TooTallNate/nixie-esp32/hardware/nixie-esp32.kicad_pcb

## KiCad design hardware/nixie-esp32.kicad_pcb (2026-09-01)

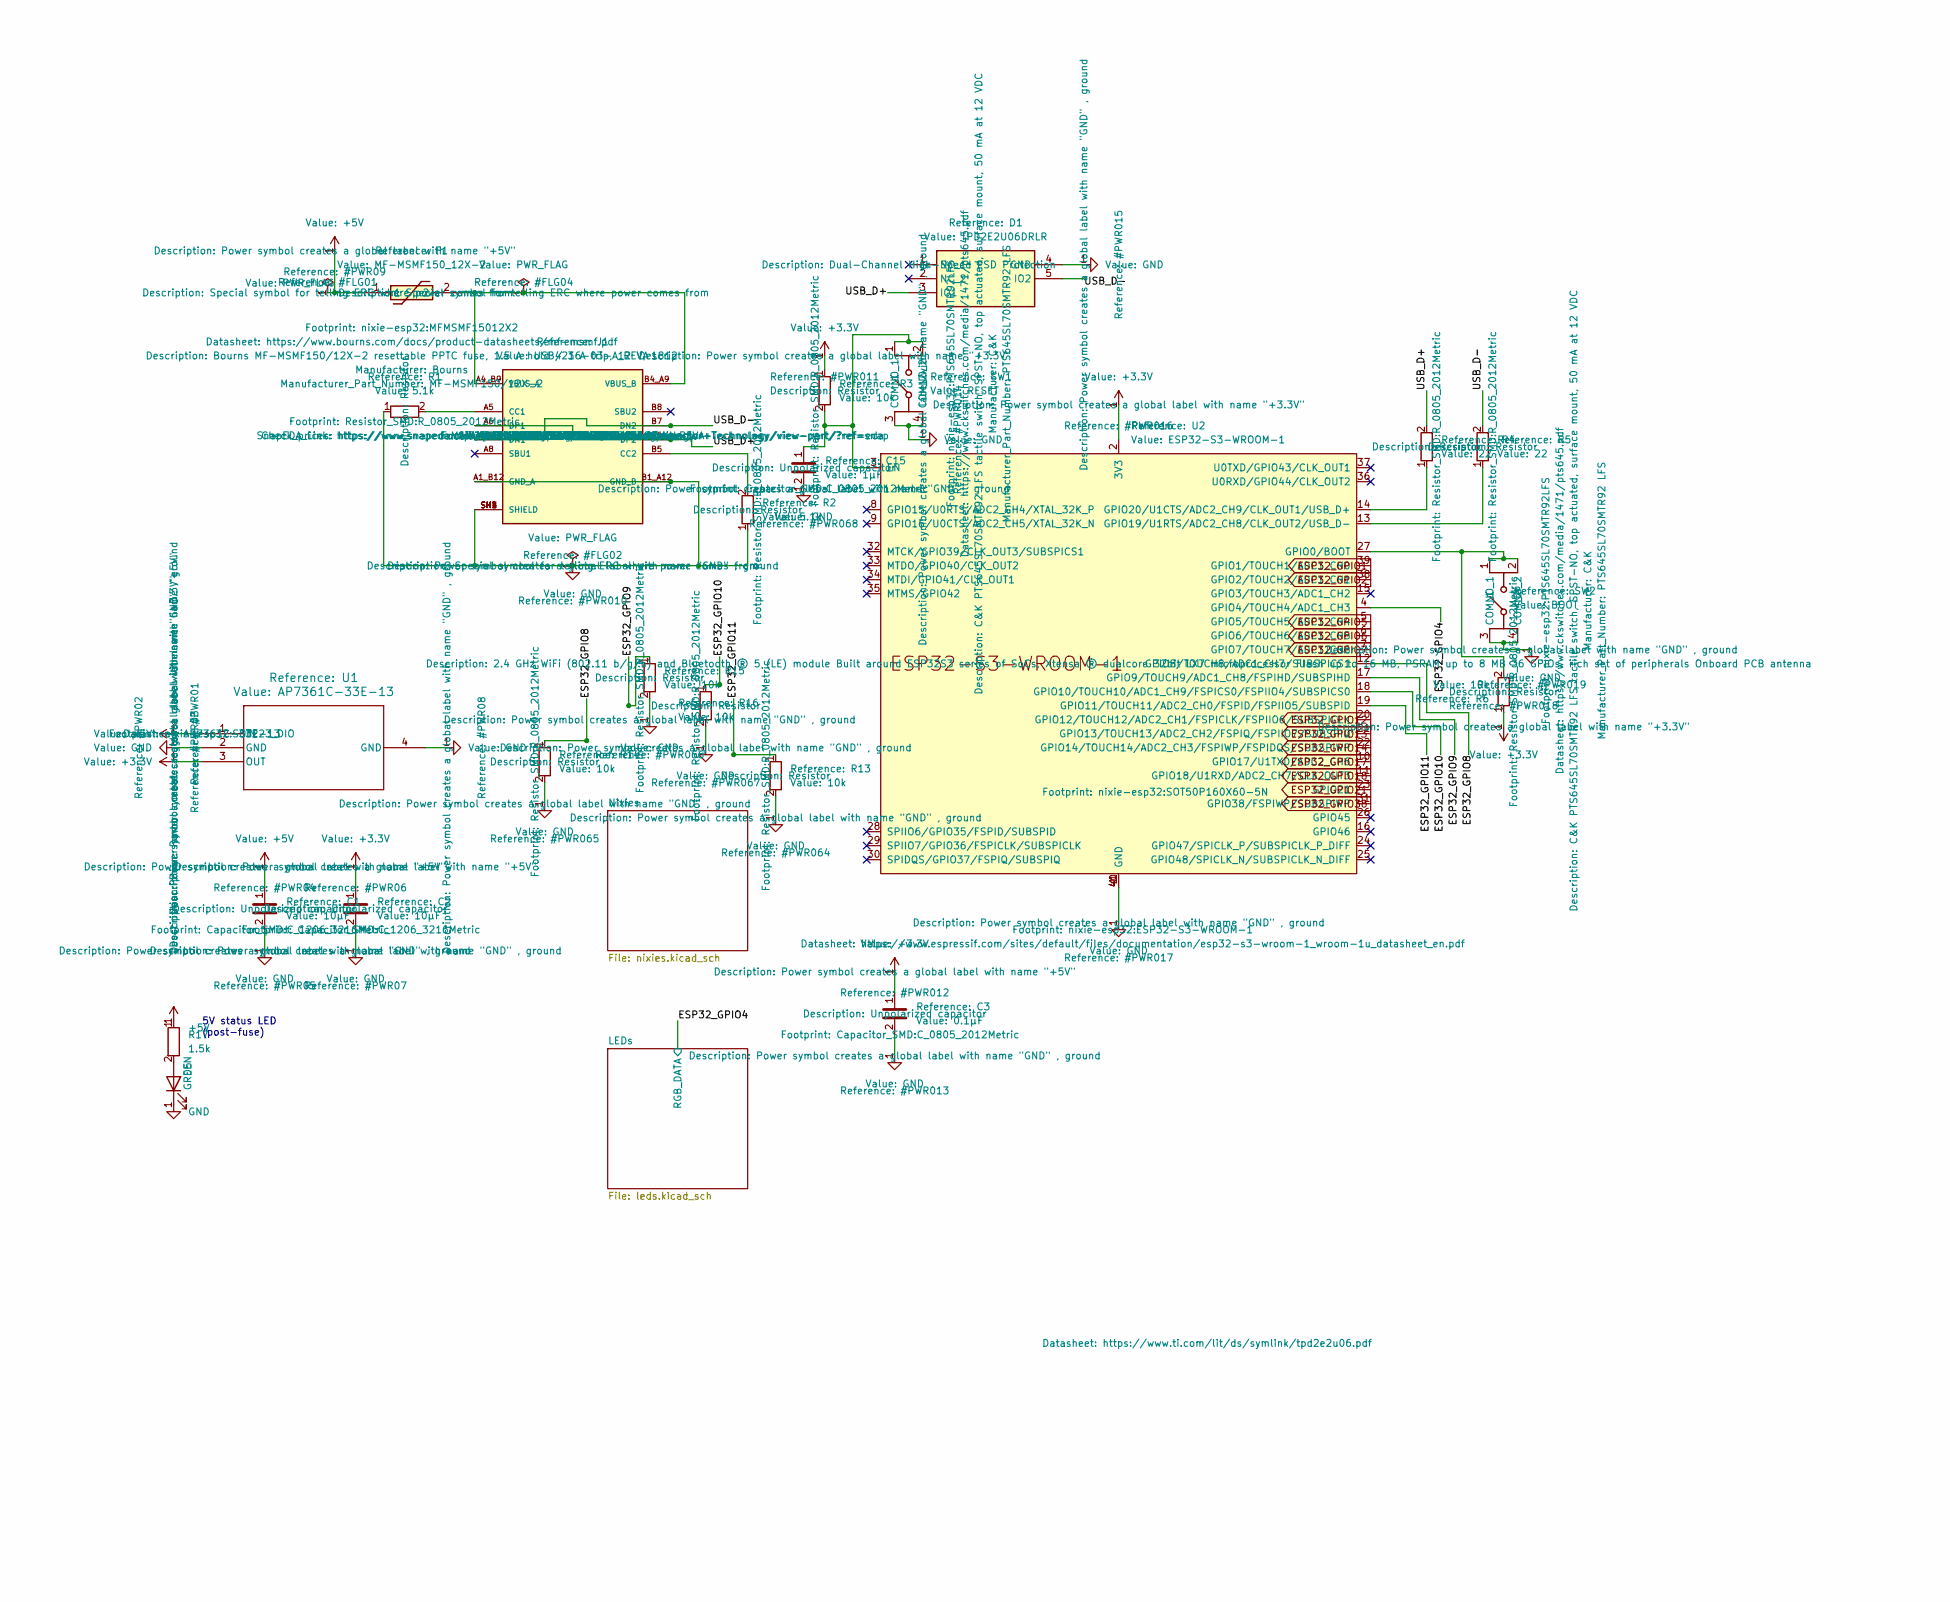
[picture p1: schematic nixie-esp32.kicad_sch, part in row 1, column 1]

Parts:
C1, C2: 10µF; C_1206_3216Metric
C3: 0.1µF; C_0805_2012Metric
C15: 1µF; C_0805_2012Metric
D1: TPD2E2U06DRLR; SOT50P160X60-5N; Mouser Part Number 595-TPD2E2U06DRLR
D5: GREEN; LED_0805_2012Metric
F1: MF-MSMF150_12X-2; MFMSMF15012X2; Manufacturer_Part_Number MF-MSMF150/12X-2
J1: USB4216-03-A_REVA; GCT_USB4216-03-A_REVA; PARTREV A
R1, R2: 5.1k; R_0805_2012Metric
R3, R6, R13, R14, R15, R16: 10k; R_0805_2012Metric
R4, R5: 22; R_0805_2012Metric
R17: 1.5k; R_0805_2012Metric
SW1: RESET; PTS645SL70SMTR92LFS; Manufacturer_Part_Number PTS645SL70SMTR92 LFS
SW2: BOOT; PTS645SL70SMTR92LFS; Manufacturer_Part_Number PTS645SL70SMTR92 LFS
U1: AP7361C-33E-13; SOT223_DIO
U2: ESP32-S3-WROOM-1

Connections:
+3.3V: C2.1, C3.1, R3.1, R6.1, U1.3 (OUT), U2.2 (3V3); also elsewhere on the board
+5V: C1.1, F1.1, R17.1, U1.1 (IN); also elsewhere on the board
/ESP32_GPIO4: U2.4 (GPIO4/TOUCH4/ADC1_CH3); also elsewhere on the board
/ESP32_GPIO8: R14.1, U2.12 (GPIO8/TOUCH8/ADC1_CH7/SUBSPICS1)
/ESP32_GPIO9: R15.1, U2.17 (GPIO9/TOUCH9/ADC1_CH8/FSPIHD/SUBSPIHD)
/ESP32_GPIO10: R16.1, U2.18 (GPIO10/TOUCH10/ADC1_CH9/FSPICS0/FSPIIO4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)
/ESP32_GPIO11: R13.1, U2.19 (GPIO11/TOUCH11/ADC2_CH0/FSPID/FSPIIO5/S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)
/USB_D+: D1.3 (IO1), J1.A6 (DP1), J1.B6 (DP2), R4.2
/USB_D-: D1.5 (IO2), J1.A7 (DN1), J1.B7 (DN2), R5.2
ESP32_GPIO1: U2.39 (GPIO1/TOUCH1/ADC1_CH0); also elsewhere on the board
ESP32_GPIO2: U2.38 (GPIO2/TOUCH2/ADC1_CH1); also elsewhere on the board
ESP32_GPIO5: U2.5 (GPIO5/TOUCH5/ADC1_CH4); also elsewhere on the board
ESP32_GPIO6: U2.6 (GPIO6/TOUCH6/ADC1_CH5); also elsewhere on the board
ESP32_GPIO7: U2.7 (GPIO7/TOUCH7/ADC1_CH6); also elsewhere on the board
ESP32_GPIO12: U2.20 (GPIO12/TOUCH12/ADC2_CH1/FSPICLK/FSPIIO6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); also elsewhere on the board
ESP32_GPIO13: U2.21 (GPIO13/TOUCH13/ADC2_CH2/FSPIQ/FSPIIO7/S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); also elsewhere on the board
ESP32_GPIO14: U2.22 (GPIO14/TOUCH14/ADC2_CH3/FSPIWP/FSPIDQS/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); also elsewhere on the board
ESP32_GPIO17: U2.10 (GPIO17/U1TXD/ADC2_CH6); also elsewhere on the board
ESP32_GPIO18: U2.11 (GPIO18/U1RXD/ADC2_CH7/CLK_OUT3); also elsewhere on the board
ESP32_GPIO21: U2.23 (GPIO21); also elsewhere on the board
ESP32_GPIO38: U2.31 (GPIO38/FSPIWP/SUBSPIWP); also elsewhere on the board
GND: C1.2, C2.2, C3.2, C15.2, D1.4 (GND), D5.1 (K), J1.A1_B12 (GND_A), J1.B1_A12 (GND_B), J1.SH1 (SHIELD), J1.SH2 (SHIELD), J1.SH3 (SHIELD), J1.SH4 (SHIELD), R1.1, R2.1, R13.2, R14.2, R15.2, R16.2, SW1.3 (COM_1), SW1.4 (COM_2), SW2.3 (COM_1), SW2.4 (COM_2), U1.2 (GND), U1.4 (GND), U2.1 (GND), U2.40 (GND), U2.41 (GND); also elsewhere on the board
unnamed: D5.2 (A), R17.2
unnamed: J1.A5 (CC1), R1.2
unnamed: J1.B5 (CC2), R2.2
unnamed: F1.2, J1.A4_B9 (VBUS_A), J1.B4_A9 (VBUS_B)
unnamed: C15.1, R3.2, SW1.1 (NO_1), SW1.2 (NO_2), U2.3 (EN)
unnamed: R6.2, SW2.1 (NO_1), SW2.2 (NO_2), U2.27 (GPIO0/BOOT)
unnamed: R5.1, U2.13 (GPIO19/U1RTS/ADC2_CH8/CLK_OUT2/USB_D-)
unnamed: R4.1, U2.14 (GPIO20/U1CTS/ADC2_CH9/CLK_OUT1/USB_D+)

Notes on the sheet:
5V status LED (post-fuse)

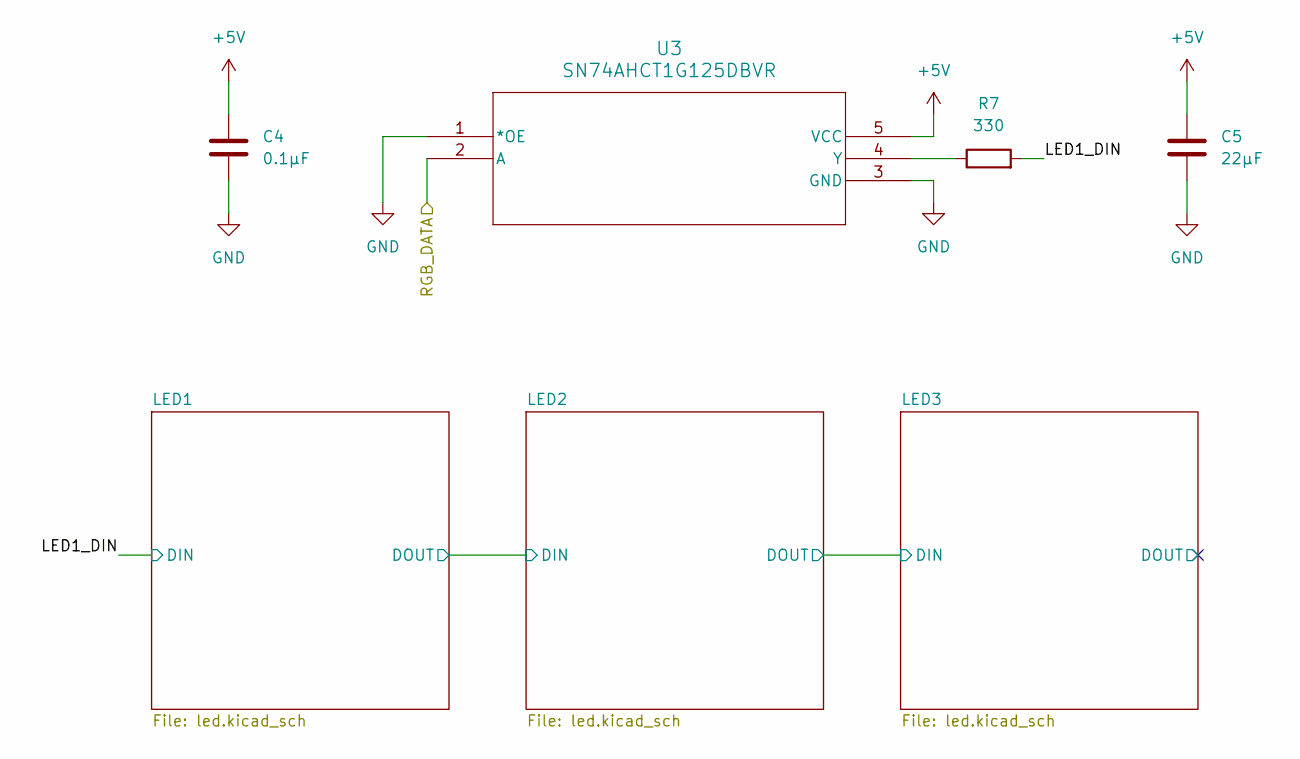
[picture p2: schematic leds.kicad_sch]

Parts:
C4: 0.1µF; C_0805_2012Metric
C5: 22µF; C_1206_3216Metric
R7: 330; R_0805_2012Metric
U3: SN74AHCT1G125DBVR; DBV5

Connections:
+5V: C4.1, C5.1, U3.5 (VCC); also elsewhere on the board
/ESP32_GPIO4: U3.2 (A); also elsewhere on the board
/LEDs/LED1_DIN: R7.2; also elsewhere on the board
GND: C4.2, C5.2, U3.1 (*OE), U3.3 (GND); also elsewhere on the board
unnamed: R7.1, U3.4 (Y)

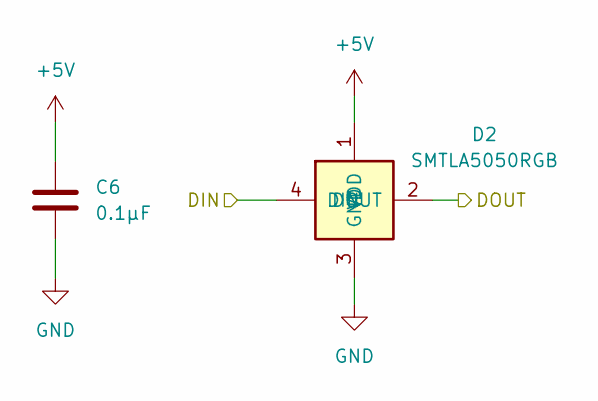
[picture p3: schematic led.kicad_sch]

Parts:
C6: 0.1µF; C_0805_2012Metric
D2: SMTLA5050RGB; Manufacturer_Part_Number SMTLA5050RGB

Connections:
+5V: C6.1, D2.1 (VDD); also elsewhere on the board
/LEDs/LED1/DOUT: D2.2 (DOUT); also elsewhere on the board
/LEDs/LED1_DIN: D2.4 (DIN); also elsewhere on the board
GND: C6.2, D2.3 (GND); also elsewhere on the board

Parts of its further copies:
C7, C8: 0.1µF; C_0805_2012Metric
D3, D4: SMTLA5050RGB; Manufacturer_Part_Number SMTLA5050RGB

Connections of its further copies:
+5V: C7.1, C8.1, D3.1 (VDD), D4.1 (VDD); also elsewhere on the board
/LEDs/LED1/DOUT: D3.4 (DIN); also elsewhere on the board
/LEDs/LED2/DOUT: D3.2 (DOUT), D4.4 (DIN)
/LEDs/LED3/DOUT: D4.2 (DOUT)
GND: C7.2, C8.2, D3.3 (GND), D4.3 (GND); also elsewhere on the board

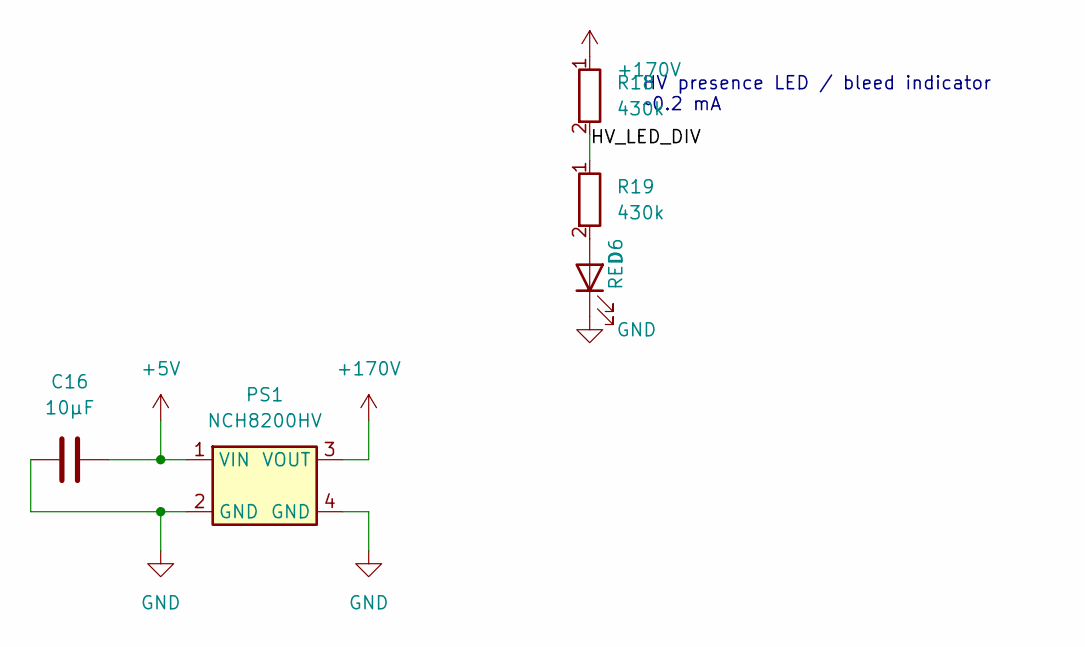
[picture p4: schematic power-170v.kicad_sch]

Parts:
C16: 10µF; C_1206_3216Metric
D6: RED; LED_0805_2012Metric
PS1: NCH8200HV
R18, R19: 430k; R_0805_2012Metric

Connections:
+5V: C16.1, PS1.1 (VIN); also elsewhere on the board
+170V: PS1.3 (VOUT), R18.1; also elsewhere on the board
/Nixies/Power170v/HV_LED_DIV: R18.2, R19.1
GND: C16.2, D6.1 (K), PS1.2 (GND), PS1.4 (GND); also elsewhere on the board
unnamed: D6.2 (A), R19.2

Notes on the sheet:
HV presence LED / bleed indicator ~0.2 mA

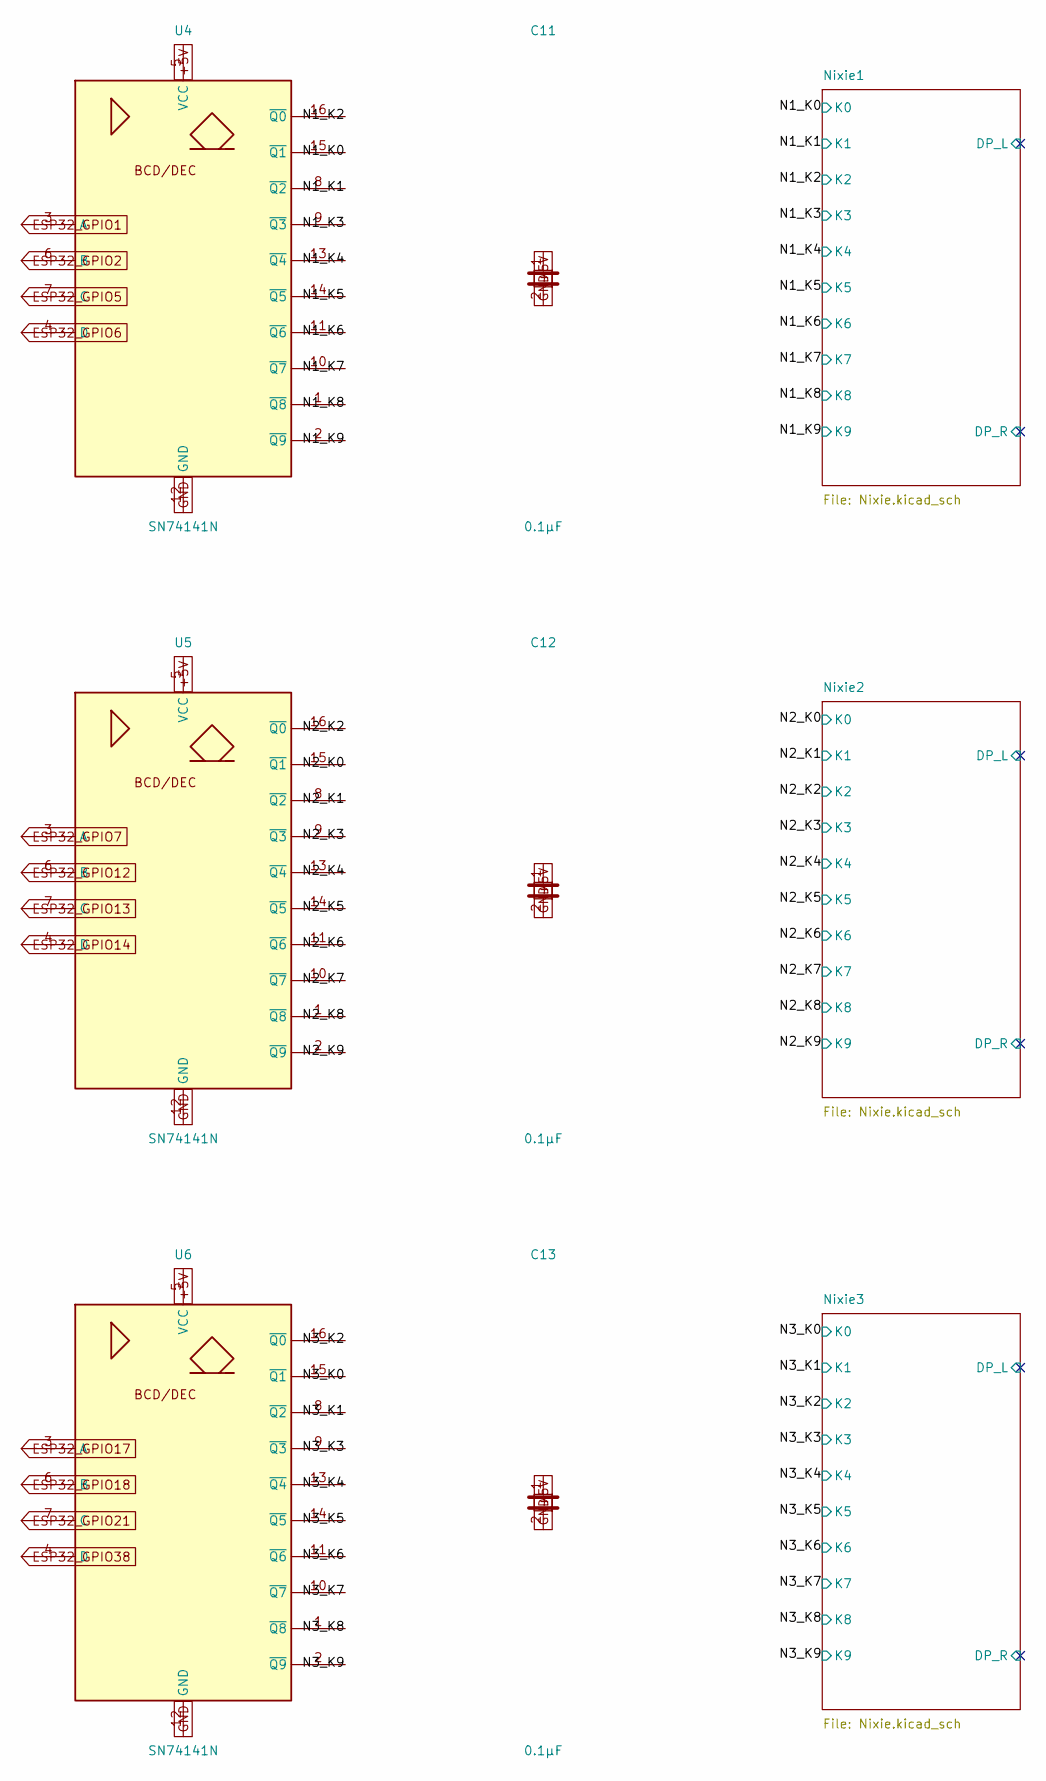
[picture p5: schematic hv-driver.kicad_sch]

Parts:
C11, C12, C13: 0.1µF; C_0805_2012Metric
U4, U5, U6: SN74141N; DIP-16_W7.62mm

Connections:
+5V: C11.1, C12.1, C13.1, U4.5 (VCC), U5.5 (VCC), U6.5 (VCC); also elsewhere on the board
/Nixies/HvDriver/N1_K0: U4.15 (~Q1); also elsewhere on the board
/Nixies/HvDriver/N1_K1: U4.8 (~Q2); also elsewhere on the board
/Nixies/HvDriver/N1_K2: U4.16 (~Q0); also elsewhere on the board
/Nixies/HvDriver/N1_K3: U4.9 (~Q3); also elsewhere on the board
/Nixies/HvDriver/N1_K4: U4.13 (~Q4); also elsewhere on the board
/Nixies/HvDriver/N1_K5: U4.14 (~Q5); also elsewhere on the board
/Nixies/HvDriver/N1_K6: U4.11 (~Q6); also elsewhere on the board
/Nixies/HvDriver/N1_K7: U4.10 (~Q7); also elsewhere on the board
/Nixies/HvDriver/N1_K8: U4.1 (~Q8); also elsewhere on the board
/Nixies/HvDriver/N1_K9: U4.2 (~Q9); also elsewhere on the board
/Nixies/HvDriver/N2_K0: U5.15 (~Q1); also elsewhere on the board
/Nixies/HvDriver/N2_K1: U5.8 (~Q2); also elsewhere on the board
/Nixies/HvDriver/N2_K2: U5.16 (~Q0); also elsewhere on the board
/Nixies/HvDriver/N2_K3: U5.9 (~Q3); also elsewhere on the board
/Nixies/HvDriver/N2_K4: U5.13 (~Q4); also elsewhere on the board
/Nixies/HvDriver/N2_K5: U5.14 (~Q5); also elsewhere on the board
/Nixies/HvDriver/N2_K6: U5.11 (~Q6); also elsewhere on the board
/Nixies/HvDriver/N2_K7: U5.10 (~Q7); also elsewhere on the board
/Nixies/HvDriver/N2_K8: U5.1 (~Q8); also elsewhere on the board
/Nixies/HvDriver/N2_K9: U5.2 (~Q9); also elsewhere on the board
/Nixies/HvDriver/N3_K0: U6.15 (~Q1); also elsewhere on the board
/Nixies/HvDriver/N3_K1: U6.8 (~Q2); also elsewhere on the board
/Nixies/HvDriver/N3_K2: U6.16 (~Q0); also elsewhere on the board
/Nixies/HvDriver/N3_K3: U6.9 (~Q3); also elsewhere on the board
/Nixies/HvDriver/N3_K4: U6.13 (~Q4); also elsewhere on the board
/Nixies/HvDriver/N3_K5: U6.14 (~Q5); also elsewhere on the board
/Nixies/HvDriver/N3_K6: U6.11 (~Q6); also elsewhere on the board
/Nixies/HvDriver/N3_K7: U6.10 (~Q7); also elsewhere on the board
/Nixies/HvDriver/N3_K8: U6.1 (~Q8); also elsewhere on the board
/Nixies/HvDriver/N3_K9: U6.2 (~Q9); also elsewhere on the board
ESP32_GPIO1: U4.3 (A); also elsewhere on the board
ESP32_GPIO2: U4.6 (B); also elsewhere on the board
ESP32_GPIO5: U4.7 (C); also elsewhere on the board
ESP32_GPIO6: U4.4 (D); also elsewhere on the board
ESP32_GPIO7: U5.3 (A); also elsewhere on the board
ESP32_GPIO12: U5.6 (B); also elsewhere on the board
ESP32_GPIO13: U5.7 (C); also elsewhere on the board
ESP32_GPIO14: U5.4 (D); also elsewhere on the board
ESP32_GPIO17: U6.3 (A); also elsewhere on the board
ESP32_GPIO18: U6.6 (B); also elsewhere on the board
ESP32_GPIO21: U6.7 (C); also elsewhere on the board
ESP32_GPIO38: U6.4 (D); also elsewhere on the board
GND: C11.2, C12.2, C13.2, U4.12 (GND), U5.12 (GND), U6.12 (GND); also elsewhere on the board

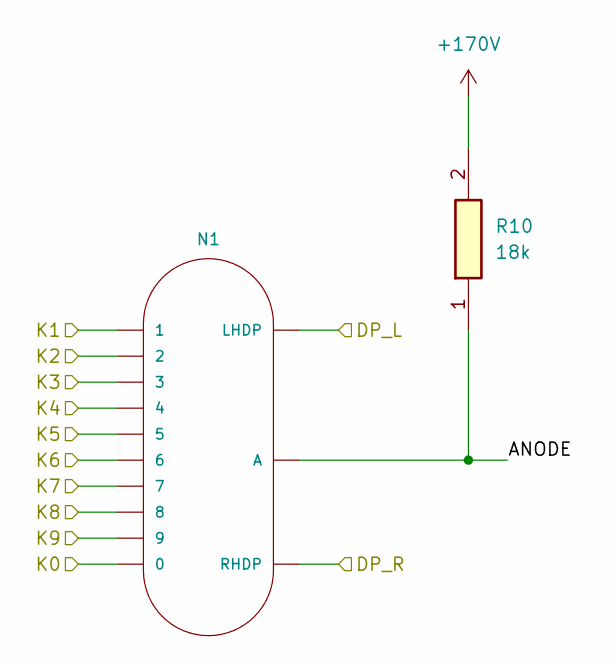
[picture p6: schematic Nixie.kicad_sch]

Parts:
N1: IN-14; nixies-us-IN-14
R10: 18k; RESC3116X65N; Tolerance 1%; Voltage_Rating 200 V; Manufacturer_Part_Number CRGH1206F18K

Connections:
+170V: R10.2; also elsewhere on the board
/Nixies/HvDriver/N1_K0: N1.0; also elsewhere on the board
/Nixies/HvDriver/N1_K1: N1.1; also elsewhere on the board
/Nixies/HvDriver/N1_K2: N1.2; also elsewhere on the board
/Nixies/HvDriver/N1_K3: N1.3; also elsewhere on the board
/Nixies/HvDriver/N1_K4: N1.4; also elsewhere on the board
/Nixies/HvDriver/N1_K5: N1.5; also elsewhere on the board
/Nixies/HvDriver/N1_K6: N1.6; also elsewhere on the board
/Nixies/HvDriver/N1_K7: N1.7; also elsewhere on the board
/Nixies/HvDriver/N1_K8: N1.8; also elsewhere on the board
/Nixies/HvDriver/N1_K9: N1.9; also elsewhere on the board
/Nixies/HvDriver/Nixie1/ANODE: N1.A, R10.1

Parts of its further copies:
N2, N3: IN-14; nixies-us-IN-14
R11, R12: 18k; RESC3116X65N; Tolerance 1%; Voltage_Rating 200 V; Manufacturer_Part_Number CRGH1206F18K

Connections of its further copies:
+170V: R11.2, R12.2; also elsewhere on the board
/Nixies/HvDriver/N2_K0: N2.0; also elsewhere on the board
/Nixies/HvDriver/N2_K1: N2.1; also elsewhere on the board
/Nixies/HvDriver/N2_K2: N2.2; also elsewhere on the board
/Nixies/HvDriver/N2_K3: N2.3; also elsewhere on the board
/Nixies/HvDriver/N2_K4: N2.4; also elsewhere on the board
/Nixies/HvDriver/N2_K5: N2.5; also elsewhere on the board
/Nixies/HvDriver/N2_K6: N2.6; also elsewhere on the board
/Nixies/HvDriver/N2_K7: N2.7; also elsewhere on the board
/Nixies/HvDriver/N2_K8: N2.8; also elsewhere on the board
/Nixies/HvDriver/N2_K9: N2.9; also elsewhere on the board
/Nixies/HvDriver/N3_K0: N3.0; also elsewhere on the board
/Nixies/HvDriver/N3_K1: N3.1; also elsewhere on the board
/Nixies/HvDriver/N3_K2: N3.2; also elsewhere on the board
/Nixies/HvDriver/N3_K3: N3.3; also elsewhere on the board
/Nixies/HvDriver/N3_K4: N3.4; also elsewhere on the board
/Nixies/HvDriver/N3_K5: N3.5; also elsewhere on the board
/Nixies/HvDriver/N3_K6: N3.6; also elsewhere on the board
/Nixies/HvDriver/N3_K7: N3.7; also elsewhere on the board
/Nixies/HvDriver/N3_K8: N3.8; also elsewhere on the board
/Nixies/HvDriver/N3_K9: N3.9; also elsewhere on the board
/Nixies/HvDriver/Nixie2/ANODE: N2.A, R11.1
/Nixies/HvDriver/Nixie3/ANODE: N3.A, R12.1

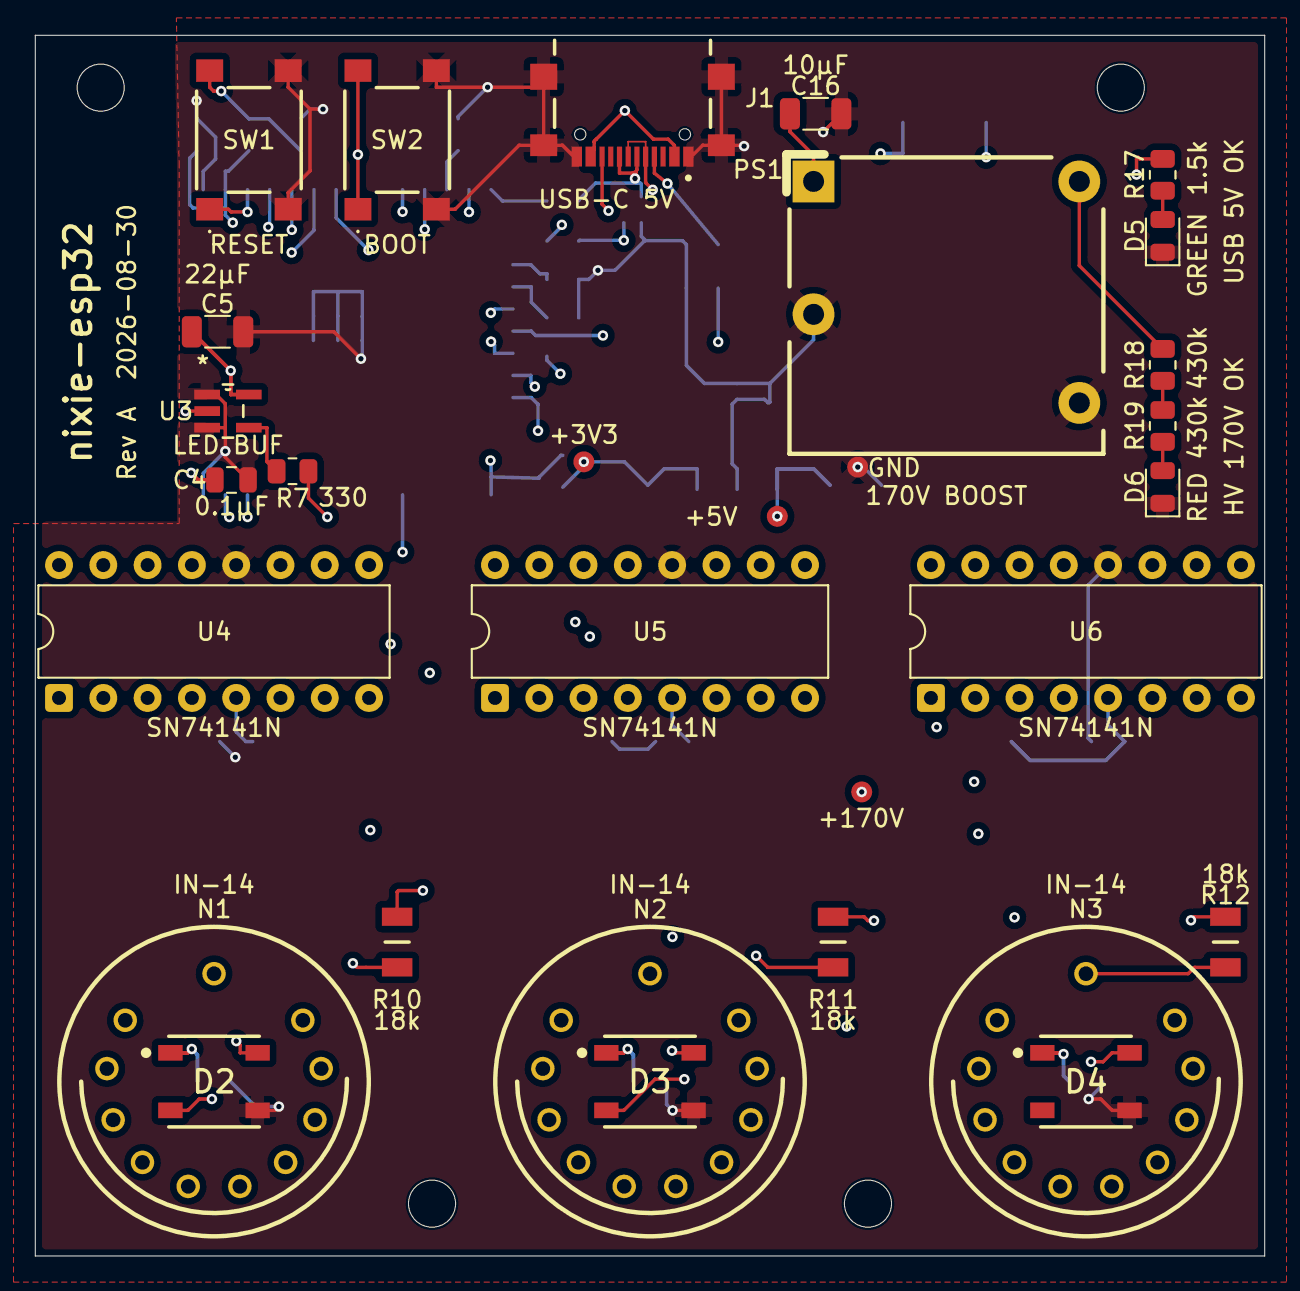
[picture p7: board nixie-esp32.kicad_pcb from above]

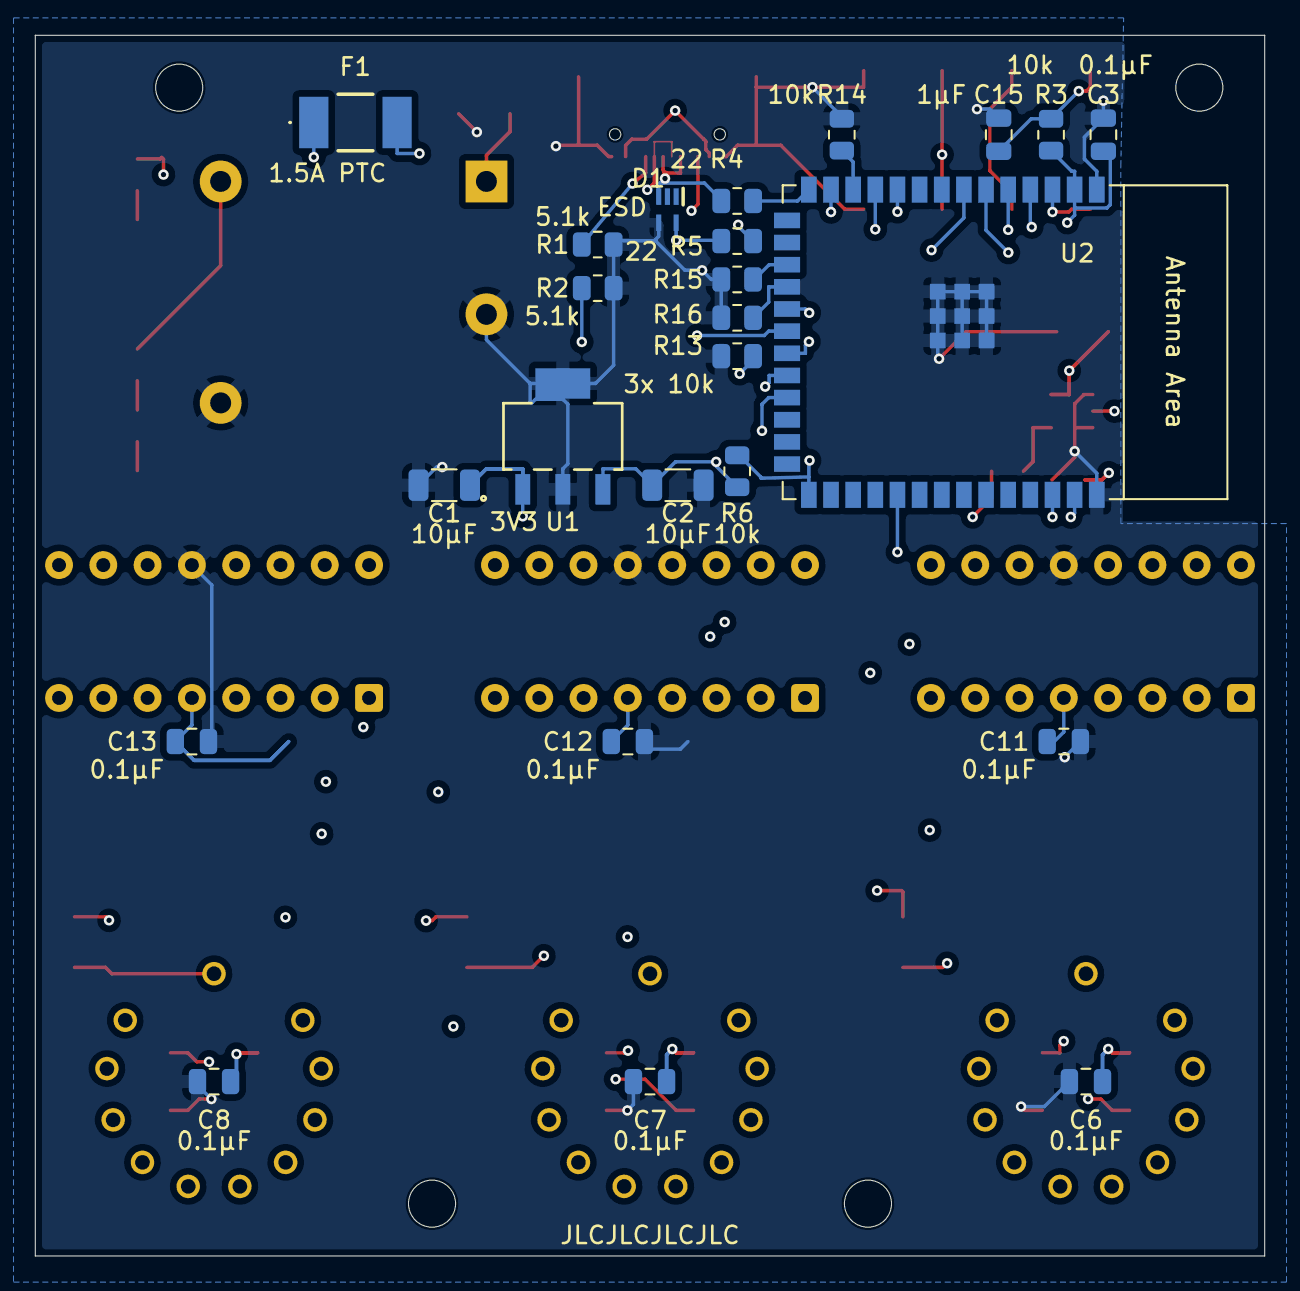
[picture p8: board nixie-esp32.kicad_pcb from below]

Board: 6 copper layers, 70.5 x 70.0 mm, 58 parts (24 on the bottom side), 70 nets.

Other parts of the board:
H1, H2, H3, H4: MountingHole_2.7mm_M2.5
TP1: GND
TP2: +3.3V
TP3: +5V
TP4: +170V

Their connections:
+3.3V: TP2.1; also elsewhere on the board
+5V: TP3.1; also elsewhere on the board
+170V: TP4.1; also elsewhere on the board
GND: TP1.1; also elsewhere on the board
