TooTallNate/nixie-esp32/(commit log)

2026-08-29 Add nixie-us symbols + footprints
2026-08-29 Add NCH8200HV High Voltage DC-DC Booster Module symbol and footprint
2026-08-29 Add NCH8200HV High Voltage DC-DC Booster Module datasheet
2026-08-29 Add nch8200hv to footprint library
2026-08-29 Progress point
    [Nixie.kicad_sch, hv-driver.kicad_sch, leds.kicad_sch, nixie-esp32.kicad_sch, nixies.kicad_sch, power-12v.kicad_sch, power-170v.kicad_sch]
2026-08-29 Lock in PTS645SL70SMTR92_LFS as the tactile BOOT/RESET buttons
    [nixie-esp32.kicad_sch]
2026-08-29 Lock in TE CRGH1206F18K as the nixie 18k resistor
    [Nixie.kicad_sch]
2026-08-29 Lock in Coilcraft MSS5131-472MLC as the 12v inductor
    [power-12v.kicad_sch]
2026-08-29 Lock in Bivar SMTLA5050RGB as the addressable RGB LED
2026-08-29 Address schematic audit findings
    - Move C15 to the ESP32 EN node for proper power-on RC delay and button reset
    - Add 10k boot-glitch pull-downs (R13-R16) on the CD4504 level shifter inputs
    - Add NCH8200HV input capacitor (C16)
    - Switch D2-D4 to the Bivar SMTLA5050RGB symbol/footprint
    - Label nixie anode nets and add HV net class with custom DRC clearance rules
    - Normalize value formats and assign missing footprints
    [Nixie.kicad_sch, led.kicad_sch, leds.kicad_sch, nixie-esp32.kicad_pcb, nixie-esp32.kicad_sch, power-12v.kicad_sch, power-170v.kicad_sch]
2026-08-29 Refine HV DRC rules and fix TPD2E2U06 datasheet link
    - Raise general HV-to-HV clearance to 1.0mm; relax to 0.2mm only within
    the HV5622 courtyard where the 0.8mm pin pitch makes wider spacing
    impossible
    - Replace the TPD2E2U06DRLR datasheet URL (was an unrelated import
    artifact) with TI's actual datasheet in both schematic and library
    [nixie-esp32.kicad_sch]
2026-08-29 Add Bourns MF-MSMF150/12X-2 PTC fuse on VBUS
    - Import symbol, 1812 footprint, and 3D model into the project library
    - F1 in series between USB VBUS and the +5V rail
    - PWR_FLAG on each side of the fuse so ERC sees both nets driven
    [nixie-esp32.kicad_sch]
2026-08-30 PCB first take at placements
    [nixie-esp32.kicad_pcb]
2026-08-30 Refine PCB component placement
    [nixie-esp32.kicad_pcb]
2026-08-30 Apply second placement audit: boost cluster, R12 edge margin, mounting holes
    [nixie-esp32.kicad_pcb]
2026-08-30 Set LED labels
    [nixie-esp32.kicad_pcb]
2026-08-30 Silkscreen pass: tidy reference labels, add board name/rev/date
    [nixie-esp32.kicad_pcb]
2026-08-30 Add visible RESET/BOOT labels below the buttons
    [nixie-esp32.kicad_pcb]
2026-08-30 Nate's bad attempt at routing traces
    [nixie-esp32.kicad_pcb]
2026-08-30 Route all nixie cathodes and anodes
    [nixie-esp32.kicad_pcb]
2026-08-31 WIP SN74141 redesign
    [hv-driver.kicad_sch, nixie-esp32.kicad_pcb, nixie-esp32.kicad_sch, nixies.kicad_sch, power-12v.kicad_sch]
2026-08-31 Route display subsystem on six layers
    [nixie-esp32.kicad_pcb]
2026-08-31 Expand board and remove display jumpers
    [nixie-esp32.kicad_pcb]
2026-08-31 Route remaining board connections
    [nixie-esp32.kicad_pcb]
2026-08-31 Align board with JLCPCB capabilities
    [nixie-esp32.kicad_pcb]
2026-08-31 Improve PCB manufacturing readiness
    [nixie-esp32.kicad_pcb]
2026-08-31 Resolve all DRC warnings
    [hv-driver.kicad_sch, nixie-esp32.kicad_pcb]
2026-08-31 Add component values and context labels to silkscreen
    [nixie-esp32.kicad_pcb]
2026-09-01 Add 5V and 170V status LED indicators
    [nixie-esp32.kicad_pcb, nixie-esp32.kicad_sch, power-170v.kicad_sch]
2026-09-01 Add gerbers
    [nixie-esp32-B_Cu.gbl, nixie-esp32-B_Mask.gbs, nixie-esp32-B_Paste.gbp, nixie-esp32-B_Silkscreen.gbo, nixie-esp32-Edge_Cuts.gm1, nixie-esp32-F_Cu.gtl, nixie-esp32-F_Mask.gts, nixie-esp32-F_Paste.gtp]
2026-09-01 BOM first take
    [mouser-bom-5x.csv]
2026-09-01 BOM second pass
    [mouser-bom-5x.csv]
2026-09-01 Import friendly BOM
    [mouser-bom-5x.csv, mouser-import-5x.csv]
